mirzetb/APRS-Tracker/APRSTracker.brd

## EAGLE design APRSTracker.brd (2016-09-07)

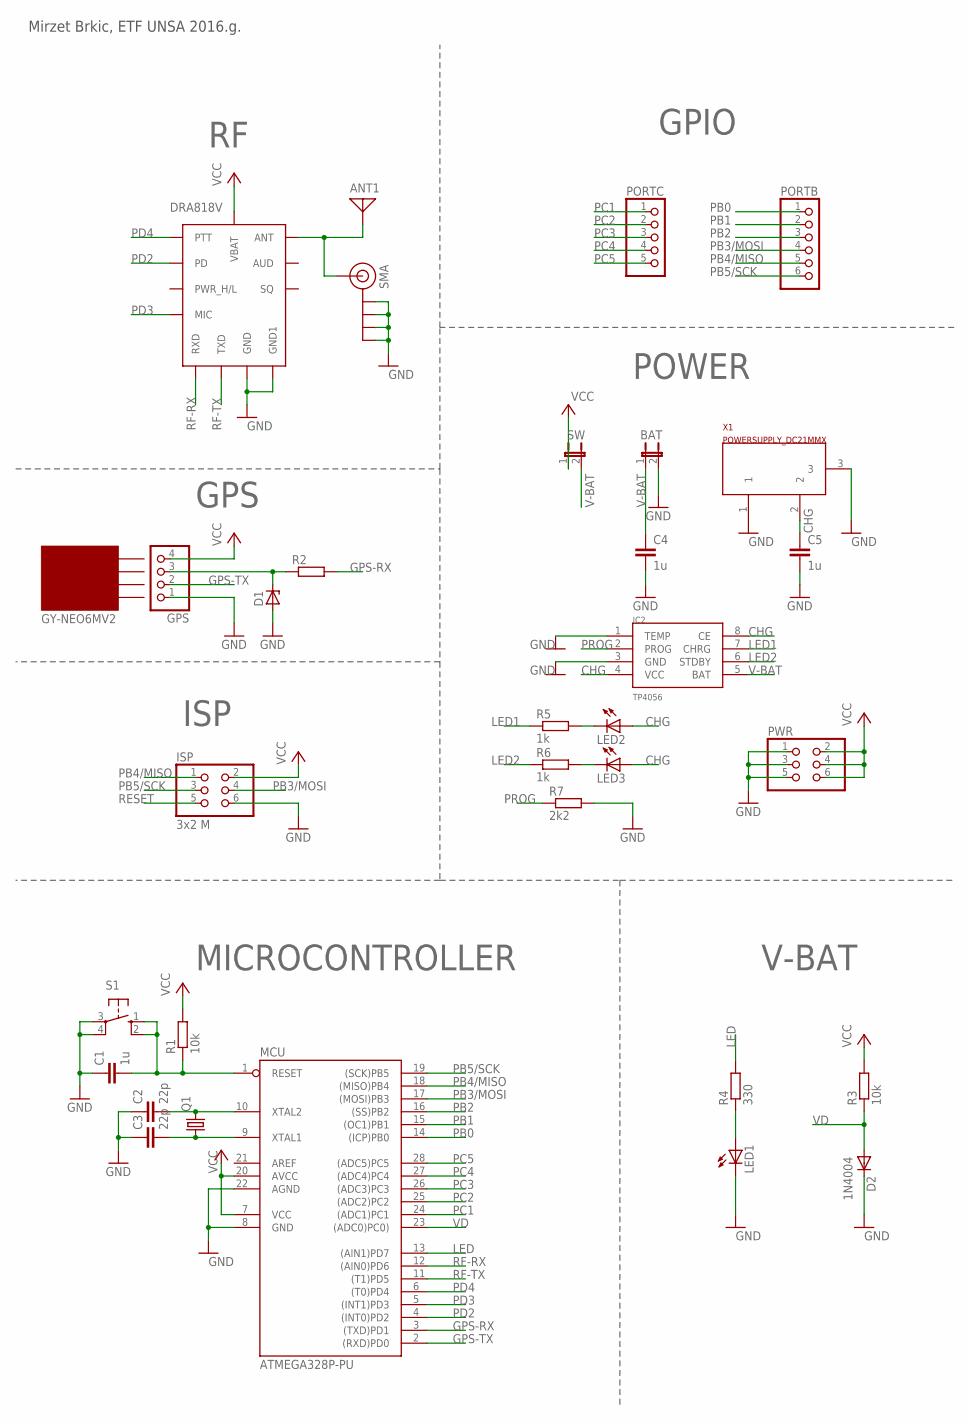
[picture p26: schematic APRSTracker.sch]

Parts:
ANT1: ANTENNA; PAD-01
BAT: JP1E; JP1
C1, C4, C5: 1u; C050-024X044
C2, C3: 22p; C025-024X044
D1: ZENER-DIODEDO35Z10; DO35Z10
D2: 1N4004; DO41-10
DRA818V: DRA818V; DRA8XXZ
GPS: PINHD-1X4; 1X04
IC2: TP4056; SOP-8
ISP: 3x2 M; 2X03
LED1, LED2, LED3: LED3MM
MCU: ATMEGA328P-PU; DIL28-3
PORTB: PINHD-1X6; 1X06
PORTC: PINHD-1X5; 1X05
PWR: PINHD-2X3; 2X03
Q1: CRYSTALHC49S; HC49/S
R1, R3: 10k; 0207/10
R2: R-EU_0207/10; 0207/10
R4: 330; 0207/10
R5, R6: 1k; 0207/10
R7: 2k2; 0207/10
S1: 10-XX; B3F-10XX
SMA: SMA_EDGE; SMA-EDGE
SW: JP1E; JP1
X1: POWERSUPPLY_DC21MMX; POWERSUPPLY_DC-21MM

Connections:
CHG: C5.1, IC2.4 (VCC), IC2.8 (CE), LED2.A, LED3.A, X1.2
GND: BAT.2, C1.1, C2.1, C3.1, C4.2, C5.2, D1.A, D2.C, DRA818V.P$9 (GND), DRA818V.P$10 (GND1), GPS.1, IC2.1 (TEMP), IC2.3 (GND), ISP.6, LED1.K (C), MCU.8 (GND), MCU.22 (AGND), PWR.1, PWR.3, PWR.5, R7.2, S1.3, S1.4 (P1), SMA.GND@0 (GND), SMA.GND@1 (GND), SMA.GND@2 (GND), SMA.GND@3 (GND), X1.1, X1.3
GPS-RX: MCU.3 ((TXD)PD1), R2.2
GPS-TX: GPS.2, MCU.2 ((RXD)PD0)
LED: MCU.13 ((AIN1)PD7), R4.2
LED1: IC2.7 (CHRG), R5.1
LED2: IC2.6 (STDBY), R6.1
unnamed: ANT1.1, DRA818V.P$12 (ANT), SMA.SIG (SIGNAL)
unnamed: D1.C, GPS.3, R2.1
unnamed: LED1.A, R4.1
unnamed: LED2.K (C), R5.2
unnamed: C3.2, MCU.9 (XTAL1), Q1.1
unnamed: C2.2, MCU.10 (XTAL2), Q1.2
unnamed: LED3.K (C), R6.2
PB0: MCU.14 ((ICP)PB0), PORTB.1
PB1: MCU.15 ((OC1)PB1), PORTB.2
PB2: MCU.16 ((SS)PB2), PORTB.3
PB3/MOSI: ISP.4, MCU.17 ((MOSI)PB3), PORTB.4
PB4/MISO: ISP.1, MCU.18 ((MISO)PB4), PORTB.5
PB5/SCK: ISP.3, MCU.19 ((SCK)PB5), PORTB.6
PC1: MCU.24 ((ADC1)PC1), PORTC.1
PC2: MCU.25 ((ADC2)PC2), PORTC.2
PC3: MCU.26 ((ADC3)PC3), PORTC.3
PC4: MCU.27 ((ADC4)PC4), PORTC.4
PC5: MCU.28 ((ADC5)PC5), PORTC.5
PD2: DRA818V.P$6 (PD), MCU.4 ((INT0)PD2)
PD3: DRA818V.P$18 (MIC), MCU.5 ((INT1)PD3)
PD4: DRA818V.P$5 (PTT), MCU.6 ((T0)PD4)
PROG: IC2.2 (PROG), R7.1
RESET: C1.2, ISP.5, MCU.1 (RESET), R1.1, S1.1 (S), S1.2 (S1)
RF-RX: DRA818V.P$16 (RXD), MCU.12 ((AIN0)PD6)
RF-TX: DRA818V.P$17 (TXD), MCU.11 ((T1)PD5)
V-BAT: BAT.1, C4.1, IC2.5 (BAT), SW.2
VCC: DRA818V.P$8 (VBAT), GPS.4, ISP.2, MCU.7 (VCC), MCU.20 (AVCC), PWR.2, PWR.4, PWR.6, R1.2, R3.2, SW.1
VD: D2.A, MCU.23 ((ADC0)PC0)), R3.1

Notes on the sheet:
GPIO
GPS
POWER
ISP
V-BAT
MICROCONTROLLER
SMA
Mirzet Brkic, ETF UNSA 2016.g.
GY-NEO6MV2

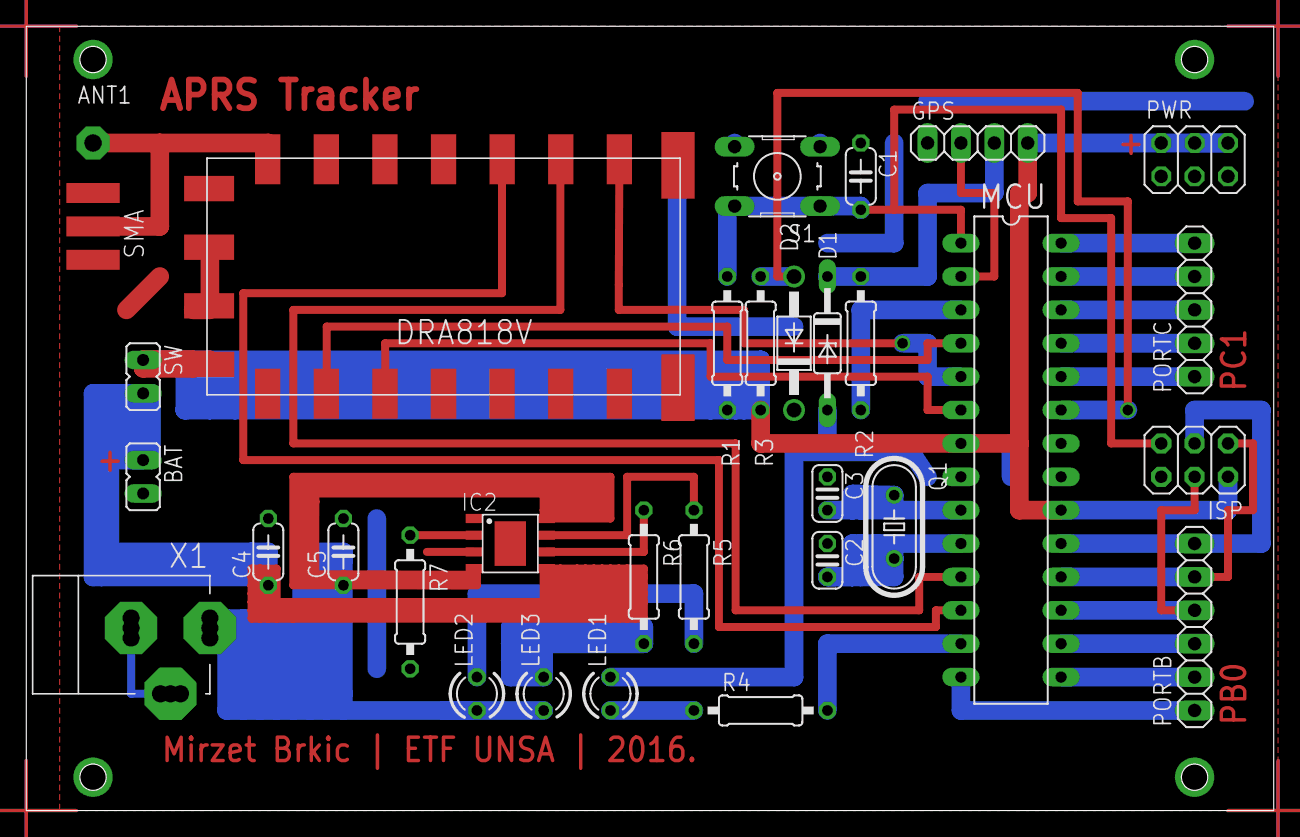
[picture p27: board APRSTracker.brd from above]

Board: 2 copper layers, 94.9 x 59.7 mm, 32 parts (0 on the bottom side), 35 nets.
