mirzetb/APRS-Tracker/APRSTracker/APRSTracker/afsk_avr.h

// trackuino copyright (C) 2010  EA5HAV Javi, APRSTracker.ino l.7

#ifdef AVR

#ifndef __AFSK_AVR_H__
#define __AFSK_AVR_H__

#include <stdint.h>
#include <avr/pgmspace.h>
#include "config.h"

#define AFSK_ISR ISR(TIMER2_OVF_vect)

// Exported consts
extern const uint32_t MODEM_CLOCK_RATE;
extern const uint8_t REST_DUTY;
extern const uint16_t TABLE_SIZE;
extern const uint32_t PLAYBACK_RATE;

// Exported vars
extern const uint8_t afsk_sine_table[] PROGMEM;

// Inline functions (this saves precious cycles in the ISR)
#if AUDIO_PIN == 3
#  define OCR2 OCR2B
#endif
#if AUDIO_PIN == 11
#  define OCR2 OCR2A
#endif

inline uint8_t afsk_read_sample(int phase)
{
  return pgm_read_byte_near(afsk_sine_table + phase);
}

inline void afsk_output_sample(uint8_t s)
{
  OCR2 = s;
}

inline void afsk_clear_interrupt_flag()
{
  // atmegas don't need this as opposed to pic32s.
}

#ifdef DEBUG_MODEM
inline uint16_t afsk_timer_counter()
{
  uint16_t t = TCNT2;
  if ((TIFR2 & _BV(TOV2)) && t < 128)
    t += 256;
  return t;
}

inline int afsk_isr_overrun()
{
  return (TIFR2 & _BV(TOV2));
}
#endif


// Exported functions
void afsk_setup();
void afsk_send(const uint8_t *buffer, int len);
void afsk_start();
bool afsk_flush();
void afsk_isr();
void afsk_timer_setup();
void afsk_timer_start();
void afsk_timer_stop();
#ifdef DEBUG_MODEM
void afsk_debug();
#endif

#endif
#endif // AVR
