mirzetb/APRS-Tracker/(commit log)

2016-06-16 shema v1
    [APRSTracker.sch]
2016-07-23 sch update
    [APRSTracker.sch]
2016-07-31 shema v2
    [APRSTracker.brd, APRSTracker.sch]
2016-08-01 brd v1
    [APRSTracker.brd, APRSTracker.sch]
2016-08-01 brd update
    [APRSTracker.brd]
2016-08-23 pcb dizajn + zakljucak 2
2016-09-07 sch & brd update
    [APRSTracker.brd, APRSTracker.sch]
