mirzetb/APRS-Tracker/(notices)

Notices in the files:
APRSTracker/APRSTracker/APRSTracker.ino:
modify it under the terms of the GNU General Public License
